becem2/Camel_STM32L4_V2/Camel_STM32L4_V2_0.png

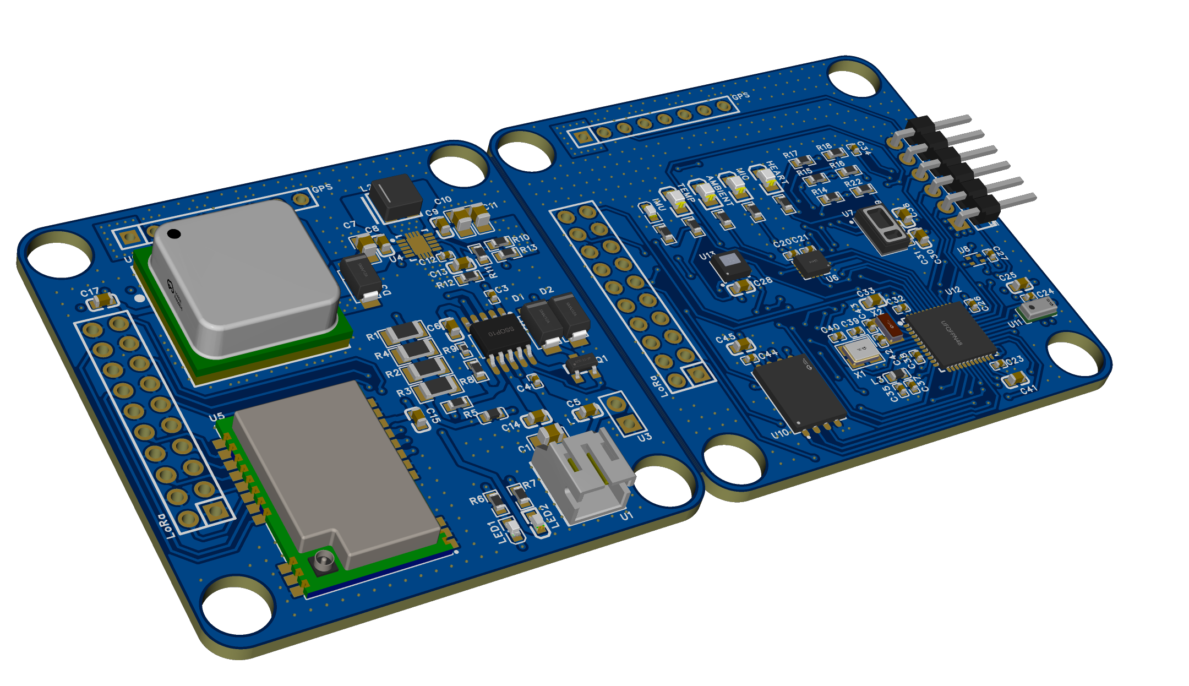
Camel_STM32L4_V2_0.png
