becem2/Camel_STM32L4_V2/Camel_STM32L4_V2_1.png

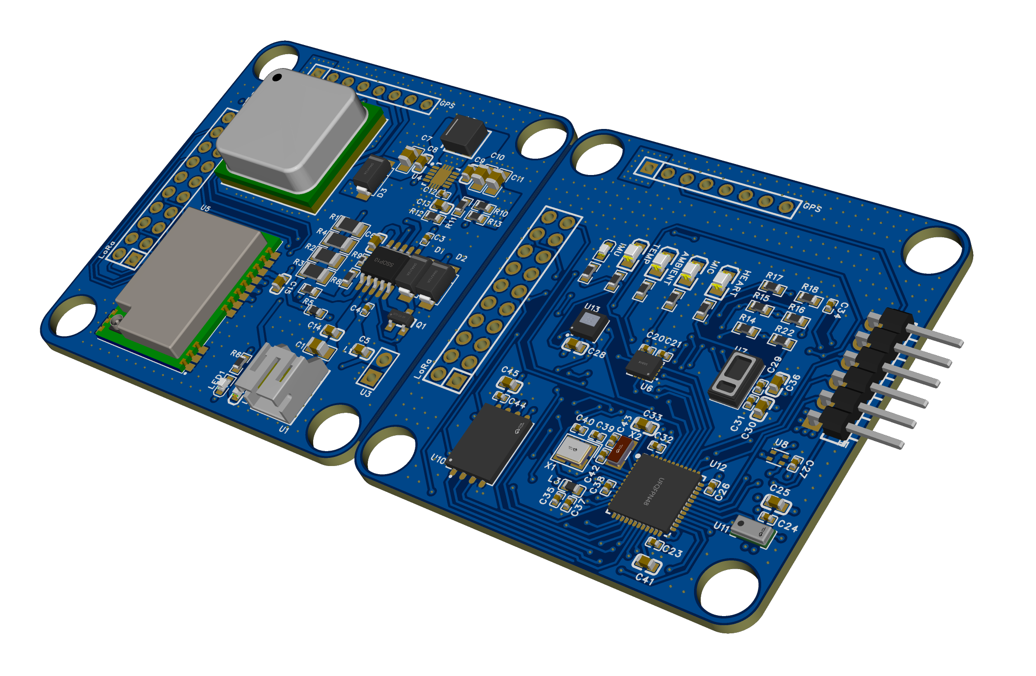
Camel_STM32L4_V2_1.png
