becem2/Camel_STM32L4_V2/Camel_STM32L4_V2_3.png

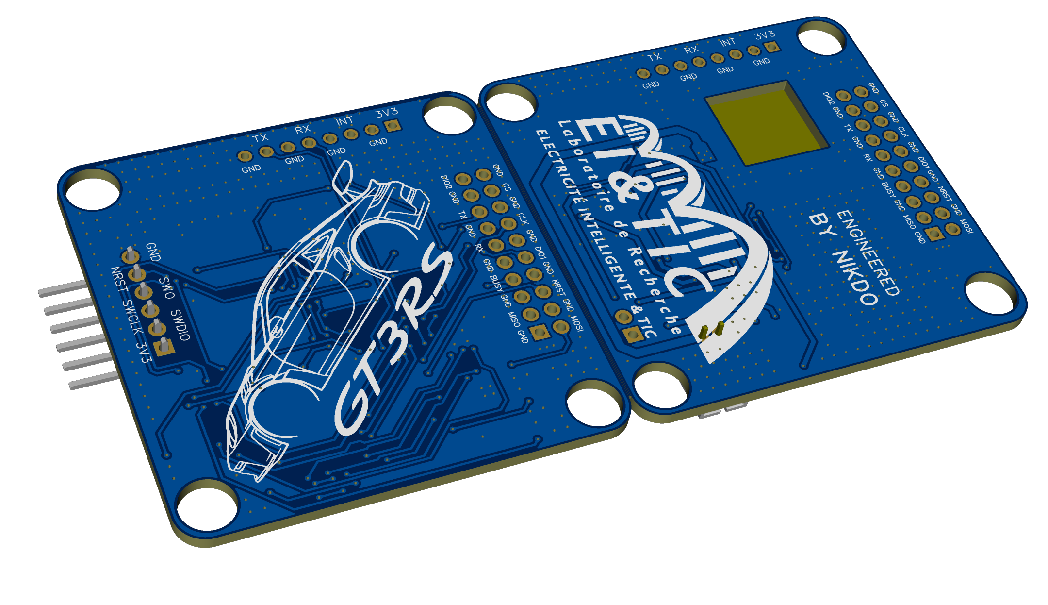
Camel_STM32L4_V2_3.png
