becem2/Camel_STM32L4_V2/Camel_STM32L4_V2_5.png

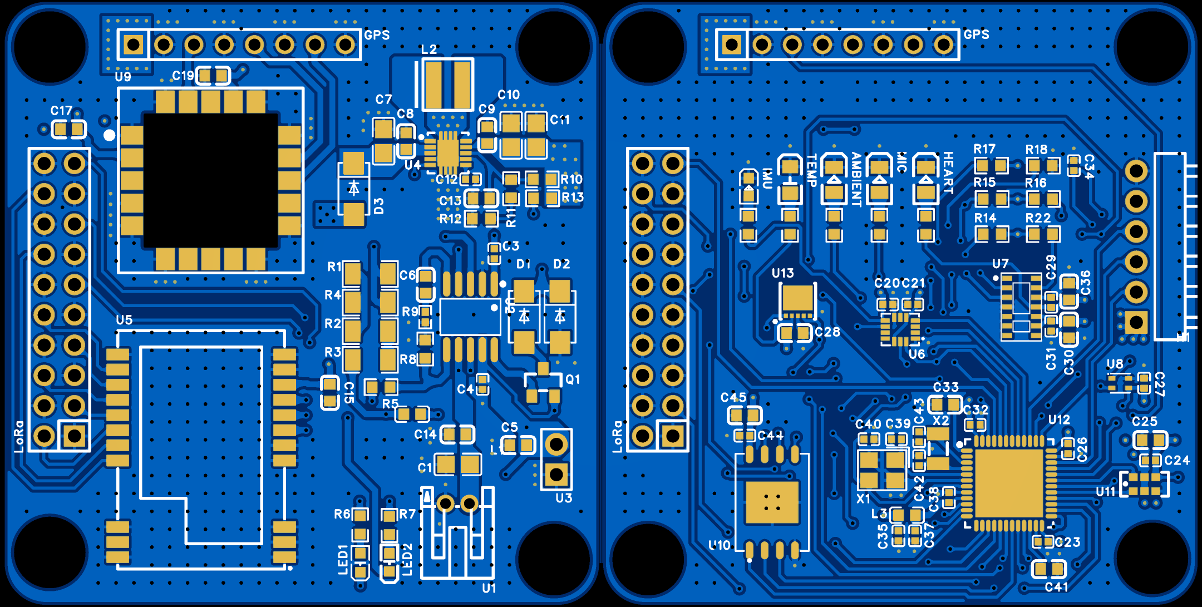
Camel_STM32L4_V2_5.png
