becem2/Camel_STM32L4_V2/(list of files, cad)

Other CAD files:
Camel_STM32L4_V2.step
Camel_STM32L4_V2.obj
