becem2/Camel_STM32L4_V2/SCH_Schematics_2026-11-09.pdf

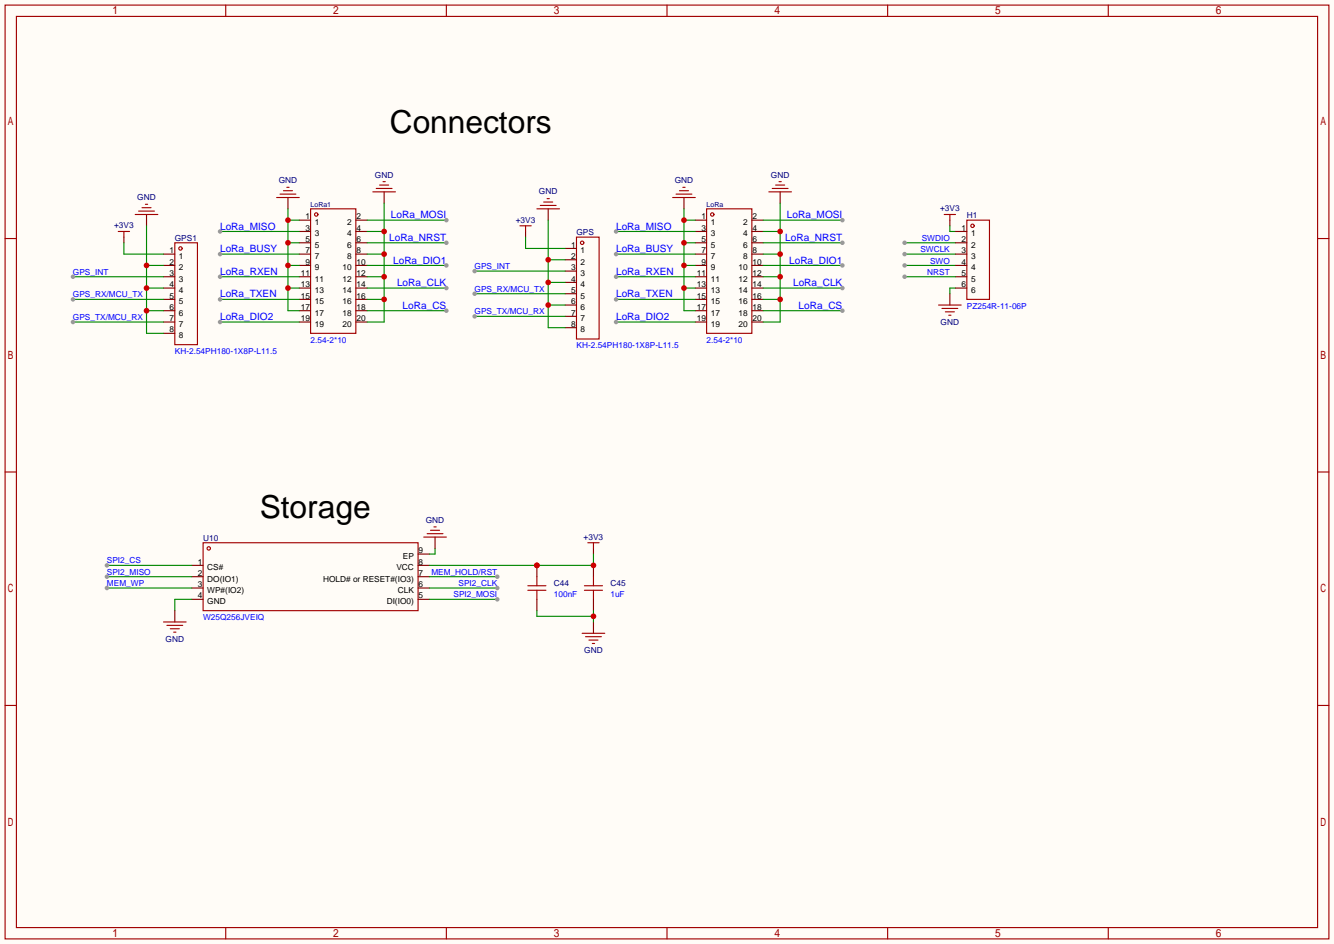
[picture p12: page 4]
