becem2/Camel_STM32L4_V2/SCH_Schematics_2026-11-09.pdf

# Charger

# Battery

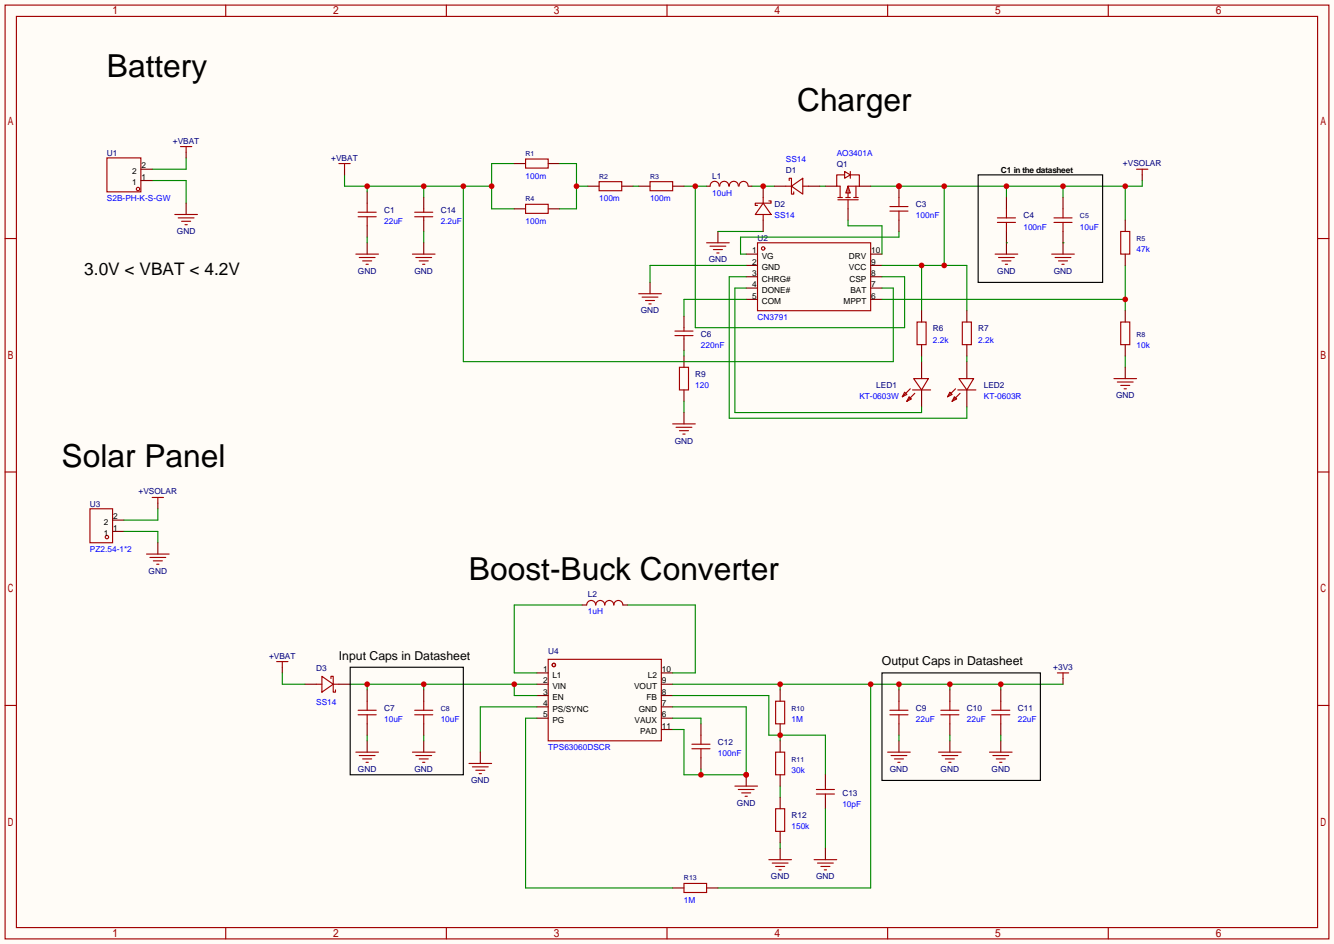
[picture p9: page 1]

## I2C ADDR GND

## I2C ADDR GND

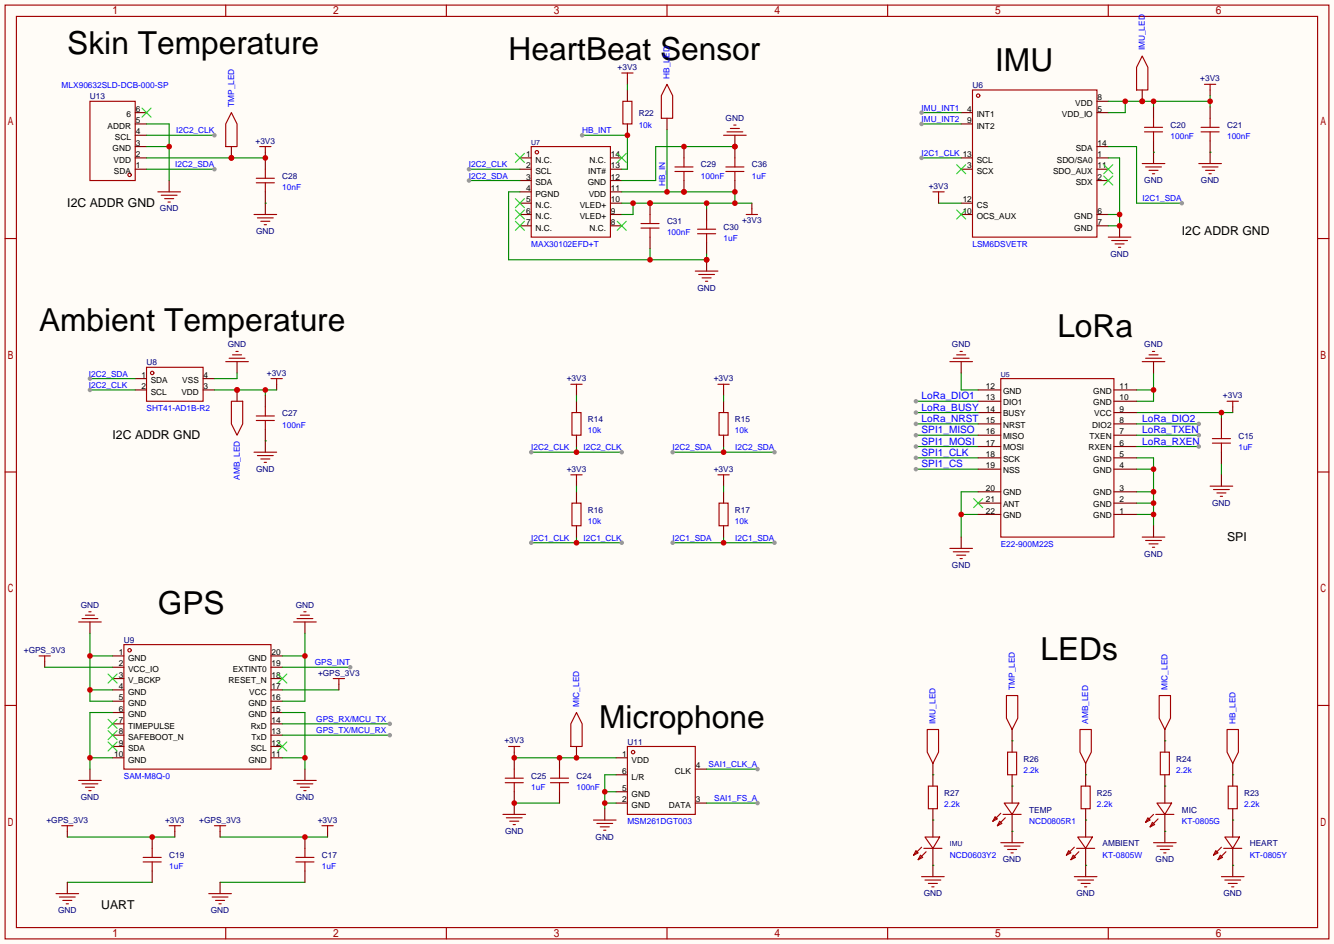
[picture p10: page 2]

VLED+ 10 VDD 11 GND 12 INT# 13 N.C. 14

BOOT0 Digital Decoupling | NRST

# Analog Decoupling

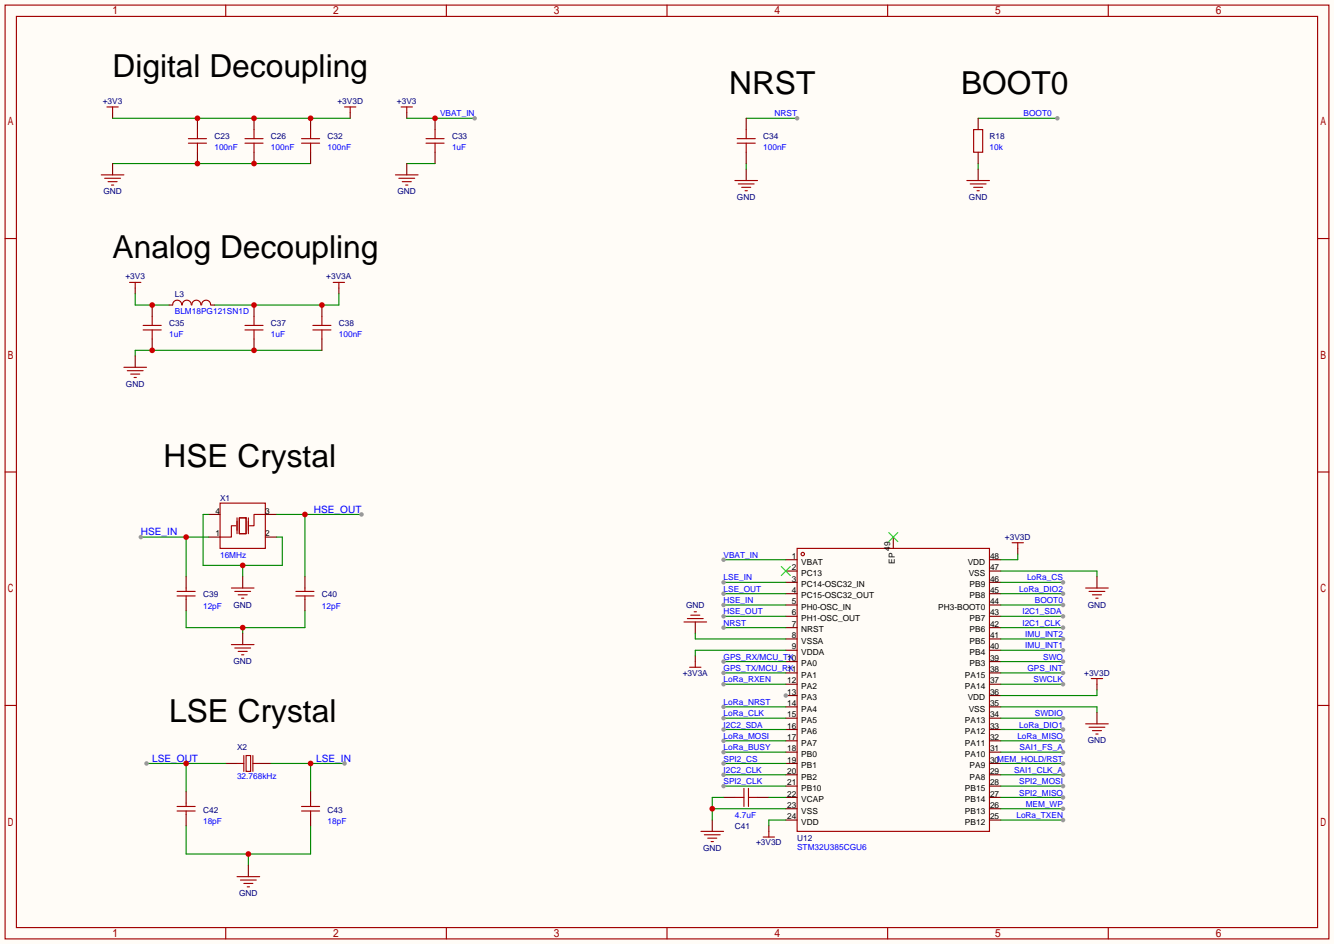
[picture p11: page 3]

# Connectors
